Chebil3/Trieur-de-skittles/README.md

# Trieur-de-skittles
Machine triant des bonbons en fonction de leur couleur :

https://www.youtube.com/watch?v=gK3C_8KzMxg (partie 1)
https://www.youtube.com/watch?v=rYbWKD9kQG8 (partie 2)
