Chebil3/Trieur-de-skittles/Rapports seances/Mandine/Rapport de Seance n°5-MANDINE.docx

Séance du 06/02/2019

Aujourd’hui nous avons découpé la séance en deux parties : Terminer le code final arduino et Commencer l’usinage des pièces.

Aziz et moi avons donc écris les dernières lignes du code qui est pour l’instant le code final de notre projet, sous réserve que nous rajoutions des fonctionnalités à notre machine.

J’ai mis ce code sur notre github… (Main.ino)

Enfin, nous avons commencé l’usinage des pièces. Et nous nous sommes rendu compte que les moyens d’usinage aux lucioles n’étaient pas assez précis donc nous sommes allés au FabLab afin d’utiliser la découpeuse laser. A cette heure-ci, il nous reste plus qu’à dessiner les fichiers de nos pièces pour la découpeuse.

Ensuite, nous pourrons assembler ces pièces et commencer à mettre en place la synchronisation code-machine…
