Chebil3/Trieur-de-skittles/Rapports seances/readme.md

Ce répertoire contient les rapport de nos séances hebdomadaire.
