Chebil3/Trieur-de-skittles/Code/Main-project.ino

#include<Servo.h>
#include<SoftwareSerial.h>
#define RX 12
#define TX 11
SoftwareSerial BlueT(RX,TX);
#define S0 4   //s0 est branché sur PD4
#define S1 5   //s1 est branché sur PD5
#define S2 6   //s2 est branché sur PD6
#define S3 7   //s3 est branché sur PD7
#define sensorOut 8  //OUT est branché sur PD8
Servo servo1;
Servo servo2;
char Data;
int frequency = 0;
int color;
int S;        //Création de variable utlisées par les fonctions de couleurs
int T;
int H;
int i;
int j;
int v;
int r=0;
int g=0;
int l=0;

void setup() {
  Serial.begin(9600);
  BlueT.begin(9600);   //Initialisation du module bluetooth
  servo1.attach(2);   //Connection du servo moteur 1 au entrée numérique 2
  servo2.attach(3);   //Connection du servo moteur 1 au entrée numérique 3
  pinMode(S0, OUTPUT);    //Configuration des entrées S0 à S3 et sensorOut en mode sortie
  pinMode(S1, OUTPUT);
  pinMode(S2, OUTPUT);
  pinMode(S3, OUTPUT);
  pinMode(sensorOut, INPUT);
  digitalWrite(S0,HIGH);    // on configure l'Output frequency scaling à 20%
  digitalWrite(S1,LOW);
}

void loop() {
  
  if (BlueT.available()) {    //Si le module bluetooth est disponible à la connexion
      Data=BlueT.read();      //Lecture du caractère envoyé par le téléphone
      if (Data=='M') {        //Si on demande à mettre en marche la machine             
        PositiveTurn(15,47,25,servo1);            //on place le bonbon sous le capteur
        delay(400);
        color = readColor();           //le capteur analyse le bonbon et va renvoyer un entier selon la couleur perçue
        Serial.print(color);
        delay(500);
        switch (color){
          case 0:            
          PositiveTurn(0,1,10,servo2);            //on tourne le tobogan jusqu'à l'angle voulu si c'est rouge
          break;
      
          case 1:
          PositiveTurn(0,45,10,servo2);           //on tourne le tobogan jusqu'à l'angle voulu si c'est vert
          break;
      
          case 2:
          PositiveTurn(0,80,10,servo2);            //on tourne le tobogan jusqu'à l'angle voulu si c'est bleu
          break;
            
          case 5:                                  //on ne tourne pas le tobogan si on ne reconnait aucune des trois couleurs 
          break;
    }
  
        delay(300);
        PositiveTurn(47,90,10,servo1);            //on emmene le bonbon au tobogan
        delay(1000);
        NegativeTurn(90,15,10,servo1);            //on bouge le moteur afin d'aller chercher le bonbon
        color=0;
        delay(1000);
        Data='M';
        
        }

        if(Data=='A') {     //Si le téléphone demande à la machine de s'arreter
          Serial.println("La machine est désactivé!");
        }
 }
}

//      Module: Analyse de la couleur générale - Capteur      //
int readColor(){
  var();
  Serial.print("R : ");
  int m=ReadRed();
  affichage(ReadRed());
  Serial.print("G : ");
  int n=ReadGreen();
  affichage(ReadGreen());
  Serial.print("B : ");
  int p=ReadBlue();
  affichage(ReadBlue());
  Serial.println(" ");
  var();
  delay(200);

  if ((n-m)>21) {
    Serial.println("ROUGE");
    return 0;
  }
  if (n<p) {
    Serial.println("VERT");
    return 1;
  }
  if (p<n) {
    Serial.println("BLEU");
    return 2;
  }
  else {
    Serial.println("INCONNU");
    return 5;
  }
}

//      Module: Analyse de la couleur rouge      //
int ReadRed() {        // On analyse la composante rouge de la source lumineuse

  digitalWrite(S2,LOW);
  digitalWrite(S3,LOW);

  while(i<5) {
   int b = pulseIn(sensorOut, LOW);
   S+=b;
   i=i+1;
   delay(100);
  
  }
  return(S/5); // on retourne la composante rouge moyenne de la souce lumineuse
}

//      Module: Analyse de la couleur verte      //
int ReadGreen() {   // On lit la composante verte de la source lumineuse

  digitalWrite(S2,HIGH);
  digitalWrite(S3,HIGH);

  while(j<5) {
    int b =  pulseIn(sensorOut, LOW);
    T+=b;
    j=j+1;
    delay(100);
  }
  return(T/5);
}

//      Module: Analyse de la couleur bleue      //
int ReadBlue() {       // On lit la composante bleue de la source lumineuse

  digitalWrite(S2,LOW);
  digitalWrite(S3,HIGH);

  while(v<5) {
    int b = pulseIn(sensorOut, LOW);
    H+=b;
    v=v+1;
    delay(100);
  }
  return(H/5);
}

String affichage(int k) {
  Serial.print(k);
  Serial.print(" ");
}

int var() {
  i=0;
  j=0;
  v=0;
  S=0;
  T=0;
  H=0;
}

//          Module Rotation Moteur            //
void PositiveTurn(int beginning,int last,int speedd, Servo moteur){
   for (int i=beginning; i<=last; i++){                           
      moteur.write(i);
      Serial.print("A");
      Serial.println(i);
      delay(speedd);}
}
void NegativeTurn(int beginning,int last,int speedd, Servo moteur){
   for (int i=beginning; i>=last; i--){                           
      moteur.write(i);
      Serial.print("B");
      Serial.println(i);
      delay(speedd);}
}
